GiorgosNtakos/Hummingbird-2-FPGA-Implementation-for-Lightweight-Authenticated-Encryption-in-IoT/Thesis_Implementation/README_GR.md

# Υλοποίηση Hummingbird-2 σε FPGA για Lightweight Authenticated Encryption στο IoT








---

## 📌 Περιγραφή

Το παρόν αποθετήριο περιέχει τον σχεδιασμό και την υλοποίηση σε υλικό ενός lightweight authenticated encryption συστήματος βασισμένου στον κρυπτογραφικό αλγόριθμο Hummingbird-2, με στόχο συσκευές Internet of Things (IoT) με περιορισμένους υπολογιστικούς πόρους.

Το σύστημα υλοποιήθηκε σε VHDL και βελτιστοποιήθηκε για αρχιτεκτονικές FPGA με έμφαση στην απόδοση, την αποδοτικότητα υλικού και την ασφάλεια. Υποστηρίζει λειτουργίες κρυπτογράφησης, αποκρυπτογράφησης, αυθεντικοποίησης και επαλήθευσης MAC για εφαρμογές RFID και ασύρματων δικτύων αισθητήρων.

---

## 🎓 Ακαδημαϊκό Πλαίσιο

Το έργο εκπονήθηκε ως **Διπλωματική Εργασία (Integrated Master)** στο:

**Τμήμα Μηχανικών Η/Υ & Πληροφορικής (CEID)**  
Πανεπιστήμιο Πατρών  

Συγγραφέας: Γεώργιος Ντάκος  
Επιβλέπων: Καθηγητής Νικόλαος Σκλάβος  
Περίοδος εκπόνησης: Δεκέμβριος 2022 — Οκτώβριος 2024  
Παρουσίαση: Οκτώβριος 2024  

---

## 🔐 Υπόβαθρο

Η ραγδαία ανάπτυξη του Internet of Things δημιουργεί αυστηρές απαιτήσεις για ασφαλή επικοινωνία σε συστήματα με περιορισμένους υπολογιστικούς πόρους. Η lightweight κρυπτογραφία παρέχει λύσεις χαμηλής κατανάλωσης, μικρού κόστους υλικού και υψηλής αποδοτικότητας.

Ο Hummingbird-2 αποτελεί έναν υβριδικό lightweight authenticated encryption αλγόριθμο σχεδιασμένο για τέτοια περιβάλλοντα, συνδυάζοντας χαρακτηριστικά block και stream ciphers και παρέχοντας εμπιστευτικότητα και ακεραιότητα δεδομένων.

---

## ⚙️ Χαρακτηριστικά Συστήματος

- Lightweight authenticated encryption (AEAD)  
- Πλήρης υλοποίηση σε VHDL  
- Υποστήριξη κρυπτογράφησης και αποκρυπτογράφησης  
- Αυθεντικοποίηση μηνυμάτων (παραγωγή και έλεγχος MAC)  
- Βελτιστοποίηση αρχιτεκτονικής ως προς απόδοση και κόστος υλικού  
- Κατάλληλο για εφαρμογές RFID και ασύρματων αισθητήρων  

---

## 🧠 Πλατφόρμα Υλικού

- FPGA στόχος: Xilinx Artix-7 (xc7a200tffg1156-3)  
- Γλώσσα υλοποίησης: VHDL  
- Προσομοίωση: ModelSim – Intel FPGA Starter Edition 10.5b  
- Σύνθεση & Υλοποίηση: Xilinx Vivado 2019.2 WebPACK Edition  

⚠️ Η υλοποίηση έχει επαληθευτεί σε μοντέλο FPGA. Μελλοντική εργασία περιλαμβάνει υλοποίηση σε πραγματική πλακέτα Basys3 Artix-7.

---

## 📂 Δομή Αποθετηρίου

/src → Πηγαίος κώδικας VHDL  
/sim → Αρχεία προσομοίωσης και testbenches  
/constraints → Αρχεία περιορισμών FPGA  
/docs → Κείμενο διπλωματικής και παρουσίαση  
/results → Αναφορές υλοποίησης και αποτελέσματα
/test_vectors → Διανύσματα Δοκιμής για επαλήθευση στα TBs   

---

## 📊 Περιοχές Εφαρμογής

- Ασφαλείς επικοινωνίες IoT  
- Συστήματα αυθεντικοποίησης RFID  
- Ασύρματα δίκτυα αισθητήρων  
- Ενσωματωμένα συστήματα ασφάλειας  
- Συσκευές με περιορισμένους πόρους  

---

## 🔮 Μελλοντική Εργασία

Προγραμματίζεται υλοποίηση και επαλήθευση σε πραγματική πλακέτα Basys3 Artix-7 για αξιολόγηση της απόδοσης σε πραγματικές συνθήκες λειτουργίας.

---

## ⚠️ Σημείωση

Η υλοποίηση παρέχεται αποκλειστικά για ακαδημαϊκούς και ερευνητικούς σκοπούς.

---

## 📖 Αναφορά (Citation)

Εάν χρησιμοποιήσετε την εργασία σε ερευνητικό ή ακαδημαϊκό πλαίσιο, παρακαλείστε να την αναφέρετε σύμφωνα με το BibTeX που παρέχεται στο κύριο README.

---

## 📜 Άδεια Χρήσης

Το έργο διατίθεται υπό την άδεια BSD 3-Clause.
