GiorgosNtakos/Hummingbird-2-FPGA-Implementation-for-Lightweight-Authenticated-Encryption-in-IoT/Thesis_Implementation/docs/thesis_presentation_final.pptx

## ΣχεδιασµΟς και ΥΛΟΠΟΙΗΣη Lightweight Authenticated ΣυστΗµατος ΚρυπτογρΑφησης, για το ΔιαδΙκτυο των ΠραγµΑτων

- Γεώργιος Ντάκος
- Επιβλέπων: Νικόλαος Σκλάβος
- Παρουσίαση Διπλωματικής Εργασίας
- Τμήμα Μηχανικών Ηλεκτρονικών Υπολογιστών και Πληροφορικής,
- Πανεπιστήμιο Πατρών
- Οκτώβριος, 2024

## Περίγραμμα Παρουσίασης

- Ανάγκη για Ασφαλή και Αποδοτικά Συστήματα στο Internet of Things (IoT)
- Υλοποίηση και Στόχοι της Εργασίας
- Ρόλος της Κρυπτογραφίας και Προκλήσεις Ασφάλειας στο IoT
- Βασικά Κρυπτογραφικά Δομικά Στοιχεία
- Οικογένεια Hummingbird (HB)
- Προτεινόμενος Σχεδιασμός και Βελτιστοποιήσεις
- Σύγκριση Αποτελεσμάτων
- Συμπεράσματα και Μελλοντικές Βελτιστοποιήσεις

## Ανάγκη για Ασφαλή και Αποδοτικά Συστήματα στο IoT

- Με τη ραγδαία ανάπτυξη του IoT απαιτούνται λύσεις με χαμηλή καθυστέρηση, υψηλή ταχύτητα και χαμηλή κατανάλωση.
- Στοχοποίηση IoT συσκευών λόγω ανεπαρκών μηχανισμών ασφαλείας και ενημερώσεων.
- Ανάγκη για αποδοτικά πρωτόκολλα ασφάλειας που προστατεύουν τα δεδομένα, εξασφαλίζοντας ταυτόχρονα υψηλή απόδοση.
- Η διείσδυση του IoT στην καθημερινή ζωή απαιτεί ασφαλείς επικοινωνίες σε τομείς όπως η υγεία και οι έξυπνες πόλεις.
- Η διασύνδεση και η μεταφορά ευαίσθητων δεδομένων αυξάνουν την πολυπλοκότητα και τον κίνδυνο των επιθέσεων.

## Υλοποίηση και Στόχοι της Εργασίας

- Υλοποίηση του HB-2:
  - Βελτιστοποιημένη έκδοση HB-2 σε FPGA, με έμφαση την αποδοτικότητα και ασφάλεια.
- Αύξηση Απόδοσης:
  - Βελτιώσεις στη συχνότητα λειτουργίας και μείωση της επιφάνειας υλικού.
- Βελτιστοποίηση Αρχιτεκτονικής:
  - Τεχνικές για μείωση κόστους και βελτίωση απόδοσης σε συσκευές με περιορισμένους πόρους.
- Προσαρμογή σε Εφαρμογές με Περιορισμένους Πόρους:
  - Σχεδιασμός για RFID και ασύρματους αισθητήρες, με στόχο την εξοικονόμηση πόρων και ασφάλεια.

## Ρόλος της Κρυπτογραφίας στο IoT & Προκλήσεις Ασφάλειας

- Ασφάλεια δικτύου.
- Αυθεντικοποίηση.
- Αξιοπιστία Επικοινωνιών.
- Περιορισμένοι Πόροι.
- Έλλειψη Προτύπων.
- Εξάρτηση από Παρόχους.
- Ελλιπής Εκπαίδευση.

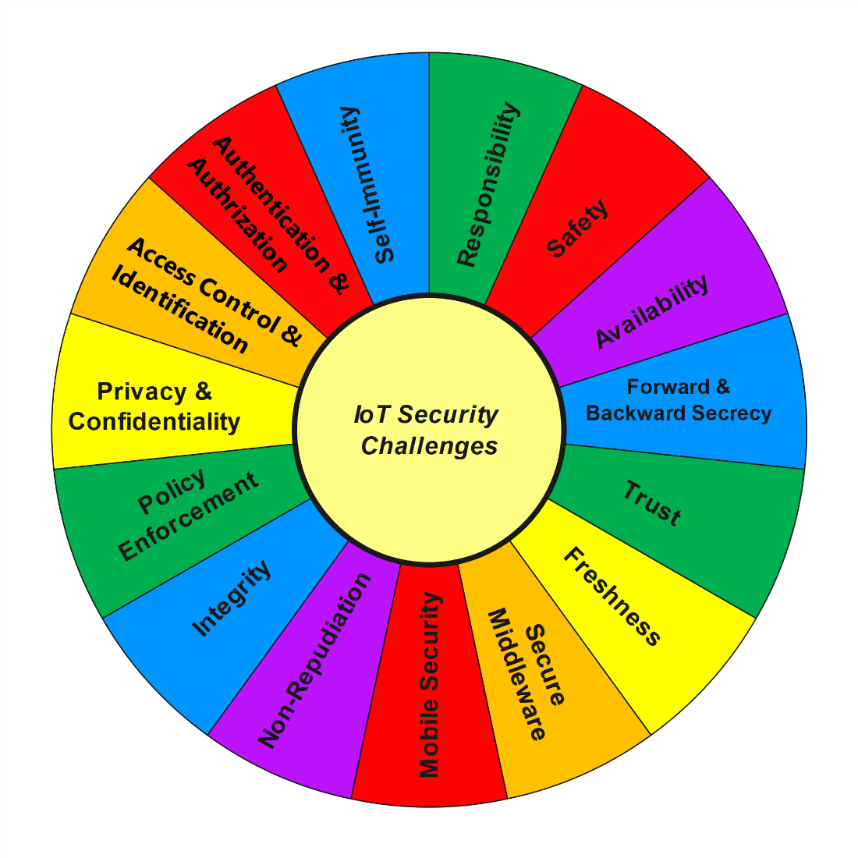
[picture p7: figure]
Εικόνα που περιέχει κείμενο, compact disc, κύκλος, συσκευή αποθήκευσης δεδομένων Περιγραφή που δημιουργήθηκε αυτόματα

## Είδη Κρυπτογραφικών Αλγορίθμων

- Δύο τύποι κρυπτογραφικών αλγορίθμων:
  - Συμμετρικοί.
  - Ασύμμετροι.
- Η επιλογή του κατάλληλου αλγόριθμου εξαρτάται από τις απαιτήσεις ασφάλειας και τους περιορισμούς των IoT συσκευών.
- Lightweight κρυπτογραφία: Συνήθης επιλογή σε IoT με περιορισμένους πόρους.
- Τύποι συμμετρικής κρυπτογράφησης:
  - Αλγόριθμοι Τμήματος (Block Ciphers).
  - Αλγόριθμοι Ροής (Stream Ciphers).

## Αλγόριθμοι Τμήματος και Δομή SPN

- Αλγόριθμοι Κρυπτογράφησης Τμήματος:
  - Επεξεργάζονται δεδομένα σε μπλοκ (64 ή 128 bits), εξασφαλίζοντας υψηλή ασφάλεια.
  - Δημοφιλείς Αρχιτεκτονικές: SPN, Feistel, ARX.
  - Πλεονεκτήματα: Υψηλή ασφάλεια, κατάλληλοι για μεγάλα δεδομένα.
  - Μειονεκτήματα: Αυξημένη πολυπλοκότητα και χαμηλότερη ταχύτητα σε σχέση με τους αλγόριθμους ροής.
- SPN Δομή:
  - Λειτουργία S-boxes: Δυσκολεύουν την ανάλυση δεδομένων.
  - Λειτουργία P-boxes: Κατανέμουν την πληροφορία ομοιόμορφα στο μπλοκ.
  - Προσθήκη Κλειδιού: Κάθε γύρος προσθέτει το κλειδί για επιπλέον ασφάλεια.

## Αλγόριθμοι Ροής

- Αλγόριθμοι Ροής:
  - Κρυπτογραφούν διαδοχικά, χρησιμοποιώντας μια κλειδοροή (keystream).
  - Πλεονεκτήματα: Υψηλή ταχύτητα, χαμηλή πολυπλοκότητα, ιδανικοί για συστήματα με περιορισμένους πόρους.
  - Μειονεκτήματα: Ευπάθεια σε επαναχρησιμοποίηση της κλειδοροής.
- Δομές :
  - LFSR
  - NFSR

## Η Οικογένεια Hummingbird

- Σχεδιασμένοι για συσκευές με περιορισμένους πόρους.
- Υβριδική δομή.
- Ιδανικοί για περιβάλλοντα με απαιτήσεις ταχείας απόκρισης και χαμηλή κατανάλωση.
- Ο HB-2 βελτιώνει την απόδοση και ασφάλεια του αρχικού HB-1.

## Γενική Αρχιτεκτονική HB-2

- Ο ΗΒ-2:
  - Αναπτύχθηκε για να βελτιώσει τον HB-1 και είναι ιδανικός για συσκευές με περιορισμένους πόρους (RFID).
  - Υλοποιείται με πράξεις των 16 bit: XOR ( ⊕ ), Modulo 2^16 (⊞) και f(x) .
- Μυστικό Κλειδί & Εσωτερική Κατάσταση:
  - Μυστικό κλειδί των 128 bit, χωρισμένο σε 8 υποκλειδιά.
  - Εσωτερική κατάσταση των 128 bit, αρχικοποιείται με διανύσματα των 64 bit.
- Αύξηση Ασφάλειας:
  - Μεγαλύτερη εσωτερική κατάσταση για περισσότερη ασφάλεια.
  - Κατάργηση του LFSR για απλοποίηση και καλύτερη απόδοση.

## S-boxes του HB-2

- Κεντρικός ρόλος στην υλοποίηση της σύγχυσης.
- Προστασία από επιθέσεις γραμμικής και διαφορικής κρυπτανάλυσης.

Τα S-boxes που χρησιμοποιούνται στην κρυπτογράφηση στον Hummingbird-2.

Τα S-boxes που χρησιμοποιούνται στην αποκρυπτογράφηση στον Hummingbird-2.

## Slide 12

- Σκοπός:
  - Ενισχύει τη διάχυση και τη σύγχυση στα δεδομένα, παρέχοντας μη γραμμικότητα και δυσκολία πρόβλεψης της εξόδου.
- Υπολογισμός:
  - S(x)= S_1 (x_0 )| S_2 (x_1 )|S_3 (x_2 )|S_4 (x_3 )
  - L(x)= x⊕(x≪6)⊕(x≪10)
  - f(x)= L(S(x))

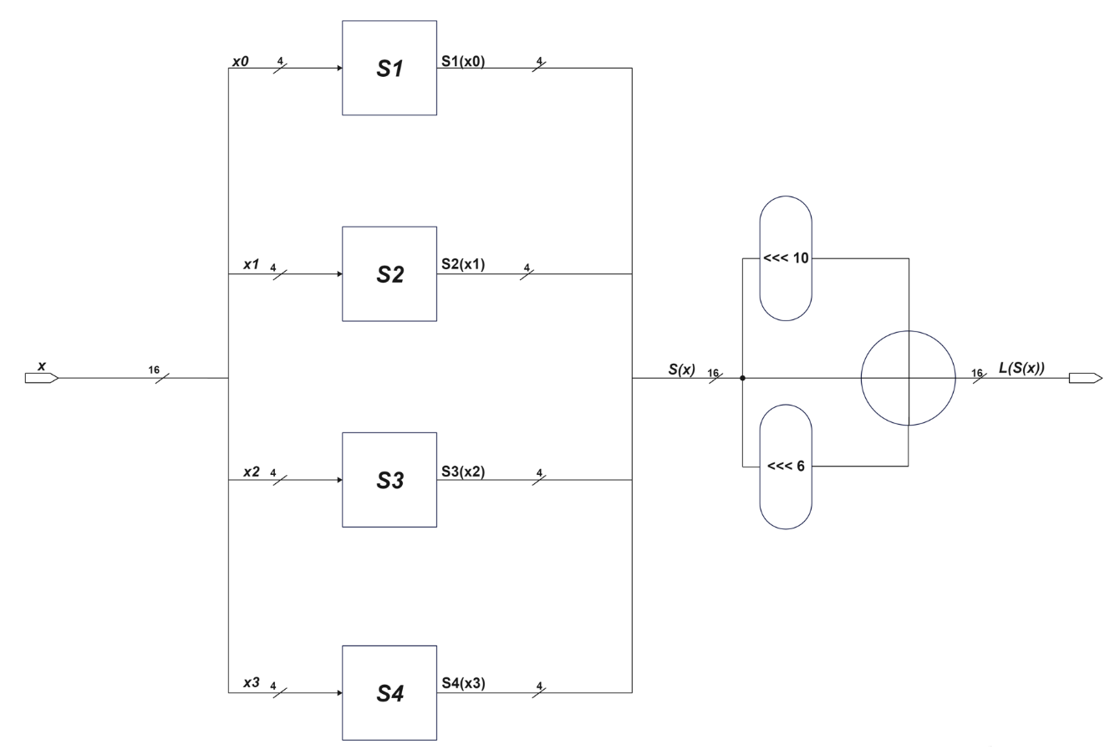
[picture p8: figure]

## Slide 13

- Παρέχει την κύρια κρυπτογραφική λειτουργία του Hummingbird-2.
- Υλοποιεί την συνάρτηση f(x) τέσσερις φορές με προσθήκη υποκλειδιών κάθε φορά.
- Βασίζεται στην SPN Δομή.
- Υπολογισμός:
  - WD16(x,a,b,c,d)=f(f(f(f(x⊕a)⊕b)⊕c)⊕d)

## Slide 14

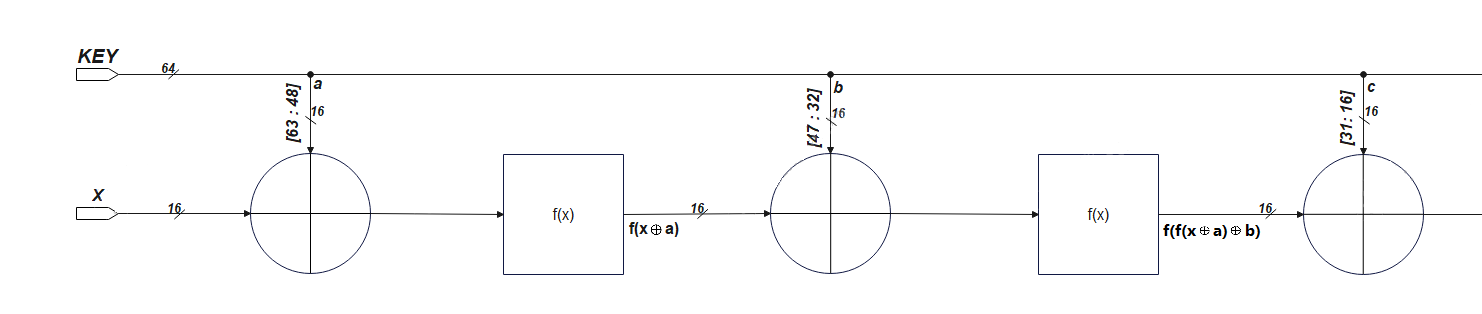
[picture p9: figure]
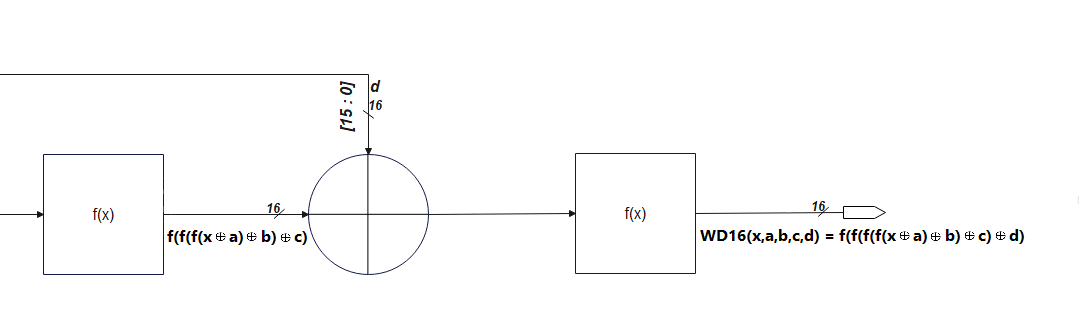
[picture p10: figure]

## Αρχιτεκτονική και Διαδικασία Αρχικοποίησης

- Σκοπός:
  - Καθορίζει την αρχική εσωτερική κατάσταση με τη χρήση του διανύσματος IV .
- Διαδικασία:
  - Χρησιμοποιούνται καταχωρητές , οι οποίοι ενημερώνονται μετά από τέσσερις γύρους.
  - Η συνάρτηση WD16 εφαρμόζεται σε κάθε γύρο με τα αντίστοιχα υποκλειδιά.

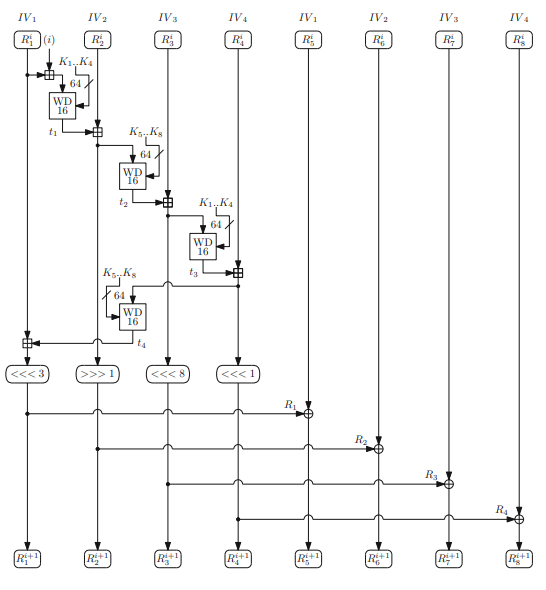
[picture p11: figure]

## Αρχιτεκτονική και Διαδικασία Κρυπτογράφησης των 16 bit Μπλοκ

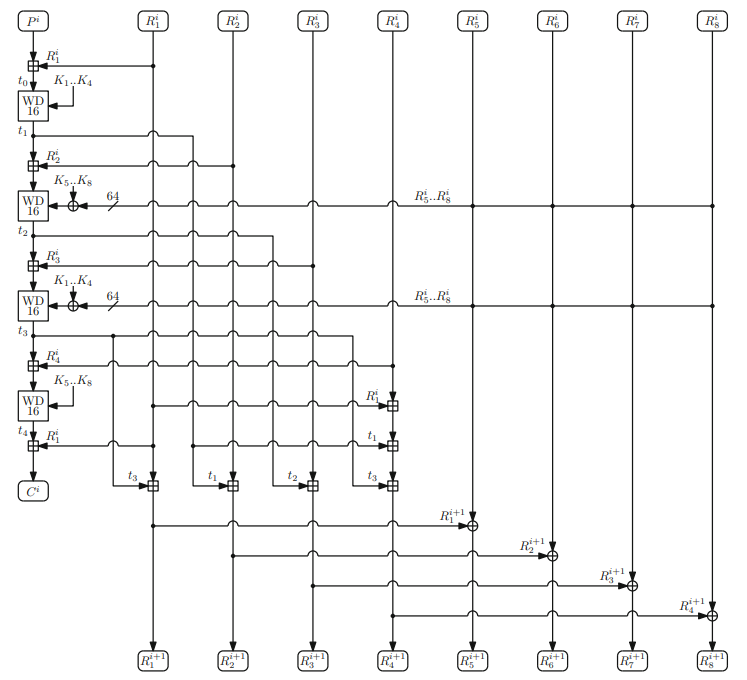
[picture p12: figure]

- Κάθε μπλοκ των 16 bit P_i κρυπτογραφείται σε τέσσερις γύρους με τη συνάρτηση WD16 .
- Υπολογισμός των γύρων:
  - t_1 =WD16(R_1^((i)) ⊞P_i , K_1 ,K_2 ,K_3 ,K_4 )
  - t_2 =WD16(R_2^((i)) ⊞t_1 , K_5 ⊕R_5^((i)) ,K_6 ⊕R_6^((i)) ,K_7 ⊕R_7^((i)) ,K_8 ⊕R_8^((i)) )
  - t_3 =WD16(R_3^((i)) ⊞t_2 , K_1 ⊕R_5^((i)) ,K_2 ⊕R_6^((i)) ,K_3 ⊕R_7^((i)) ,K_4 ⊕R_8^((i)) )
  - C_i =WD16(R_4^((i)) ⊞t_3 , K_5 ,K_6 ,K_7 ,K_8 )⊞R_1^((i))

## Stream Cipher Κωδικοποίηση Πεδίων Μικρού Μήκους

- Σχεδιάστηκε για μηνύματα μικρότερα από 16 bits ( 1≤n≤15 ) χωρίς αύξηση του μεγέθους.
- Διαδικασία:
  - Κρυπτογράφηση με τη μηδενική λέξη E(0) των 16 bit.
  - Το τελικό μήνυμα υπολογίζεται ως x⊕E(0) .
  - Παρέχεται επιπλέον ασφάλεια με ενημέρωση της εσωτερικής κατάστασης.

## Μονάδα Υπολογισμού MAC

- Παρέχει ακεραιότητα και αυθεντικότητα στα μηνύματα του HB-2.
- Διαδικασία Υπολογισμού:
  - Τρεις κλήσεις της E για την ενημέρωση της εσωτερικής κατάστασης:
    - E(IV_1 ⊞R_1 ⊞R_3 ⊞n)
    - E(IV_2 ⊞R_1 ⊞R_3 )
    - E(IV_3 ⊞R_1 ⊞R_3 )
- Παραγωγή MAC:
  - T_1 =E(IV_4 ⊞R_1 ⊞R_3 )
  - T_i =E(R_1 ⊞R_3 ), με i=2,3,…,n

## Slide 19

- Η αντίστροφη της f(x) υπολογίζεται ως:
  - f^(−1) (x)=L^(−1) (S^(−1) (y))
  - L^(−1) (x)=y⊕(x_(old) ≫6 )⊕ (x_(old) ≫10 )
  - word_(output) =S_1^(−1) (x_(new_0) )|S_2^(−1) (x_(new_1) )|S_3^(−1) (x_(new_2) )|S_4^(−1) (x_(new_3) )
- Αντιστροφή της WD16:
  - WD16^(−1) (x,a,b,c,d)=f^(−1) (f^(−1) (f^(−1) (f^(−1) (x⊕a)⊕b)⊕c)⊕d)

## Slide 20

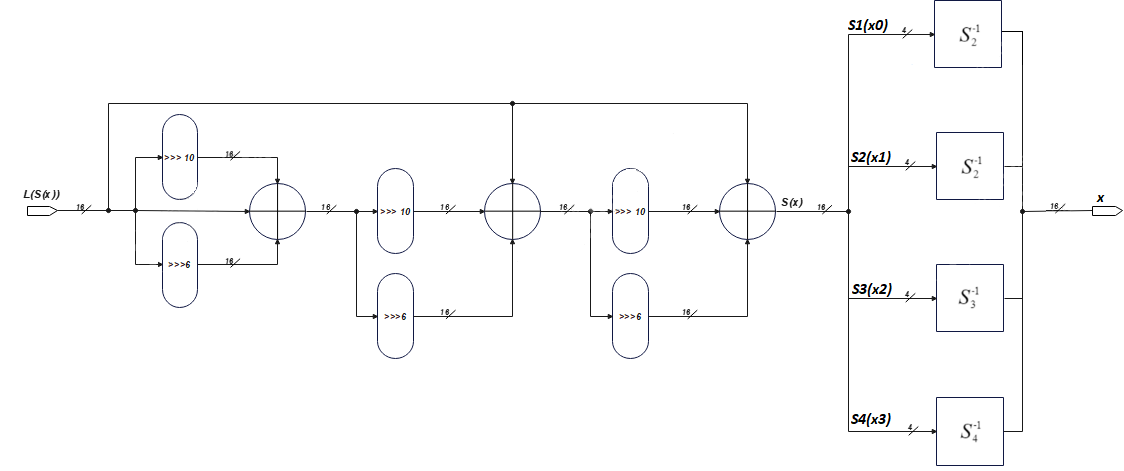
[picture p13: figure]
Εικόνα που περιέχει διάγραμμα, γραμμή, τεχνικό σχέδιο, Σχέδιο Περιγραφή που δημιουργήθηκε αυτόματα

## Slide 21

/

64

WD(x,a,b,c,d)

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
WD16⁻¹(x,a,b,c,d)

/

## Αρχιτεκτονική και Διαδικασία Αποκρυπτογράφησης

- Αποκρυπτογράφηση:
  1. u_3 =WD16^(−1) (C_i ⊟R_1^((i)) , K_8 ,K_7 ,K_6 ,K_5 )
  2. u_2 =WD16^(−1) (u_3 ⊟R_4^((i)) , K_4 ⊕R_8^((i)) ,K_3 ⊕R_7^((i)) ,K_2 ⊕R_6^((i)) ,K_1 ⊕R_5^((i)) )
  3. u_1 =WD16^(−1) (u_2 ⊟R_3^((i)) , K_8 ⊕R_8^((i)) ,K_7 ⊕R_7^((i)) ,K_6 ⊕R_6^((i)) ,K_5 ⊕R_5^((i)) )
  4. P_i =WD16^(−1) (u_i ⊟R_2^((i)) , K_4 ,K_3 ,K_2 ,K_1 )
- Η εσωτερική κατάσταση ενημερώνεται:
  - t_3 =u_3 ⊟R_4^((i))
  - t_2 =u_2 ⊟R_3^((i))
  - t_1 =u_1 ⊟R_2^((i))

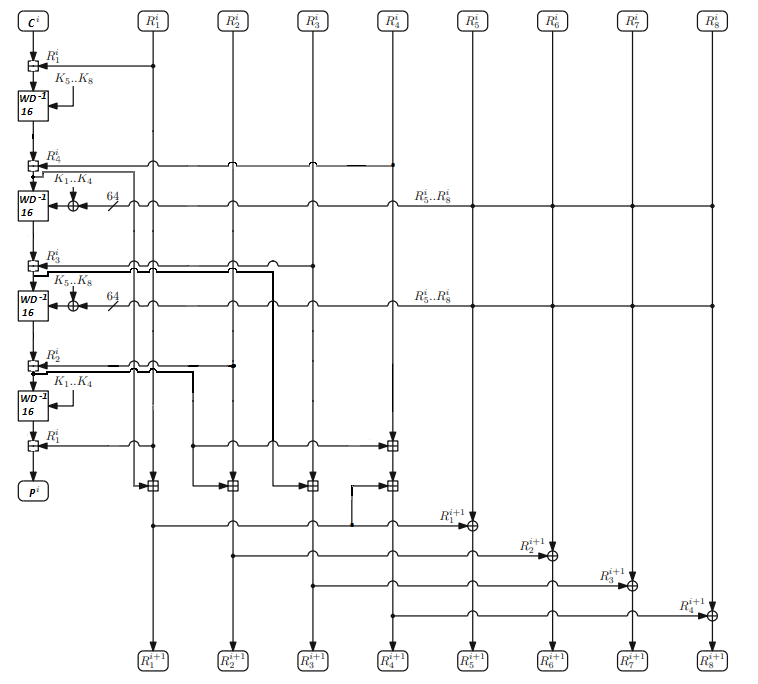
[picture p14: figure]

## Προτεινόμενος Σχεδιασμός HB-2

Σχεδιάστηκε επεξεργαστής HB-2 για 128 bit μπλοκ, με βασικές λειτουργίες:
  - Αρχικοποίηση (Initialization).
  - Κρυπτογράφηση (Encryption).
  - Λειτουργία stream cipher με ενσωματωμένη ακεραιότητα (Stream cipher mode with integrated integrity).
  - Αυθεντικοποίηση (Authentication).
  - Έλεγχος MAC (MAC verification unit).
Για την ομαλή λειτουργία και απόδοση:
  - Μηχανή πεπερασμένων καταστάσεων (FSM).
  - Μονάδα διαχείρισης σημάτων ελέγχου.

## Μηχανή πεπερασμένων καταστάσεων

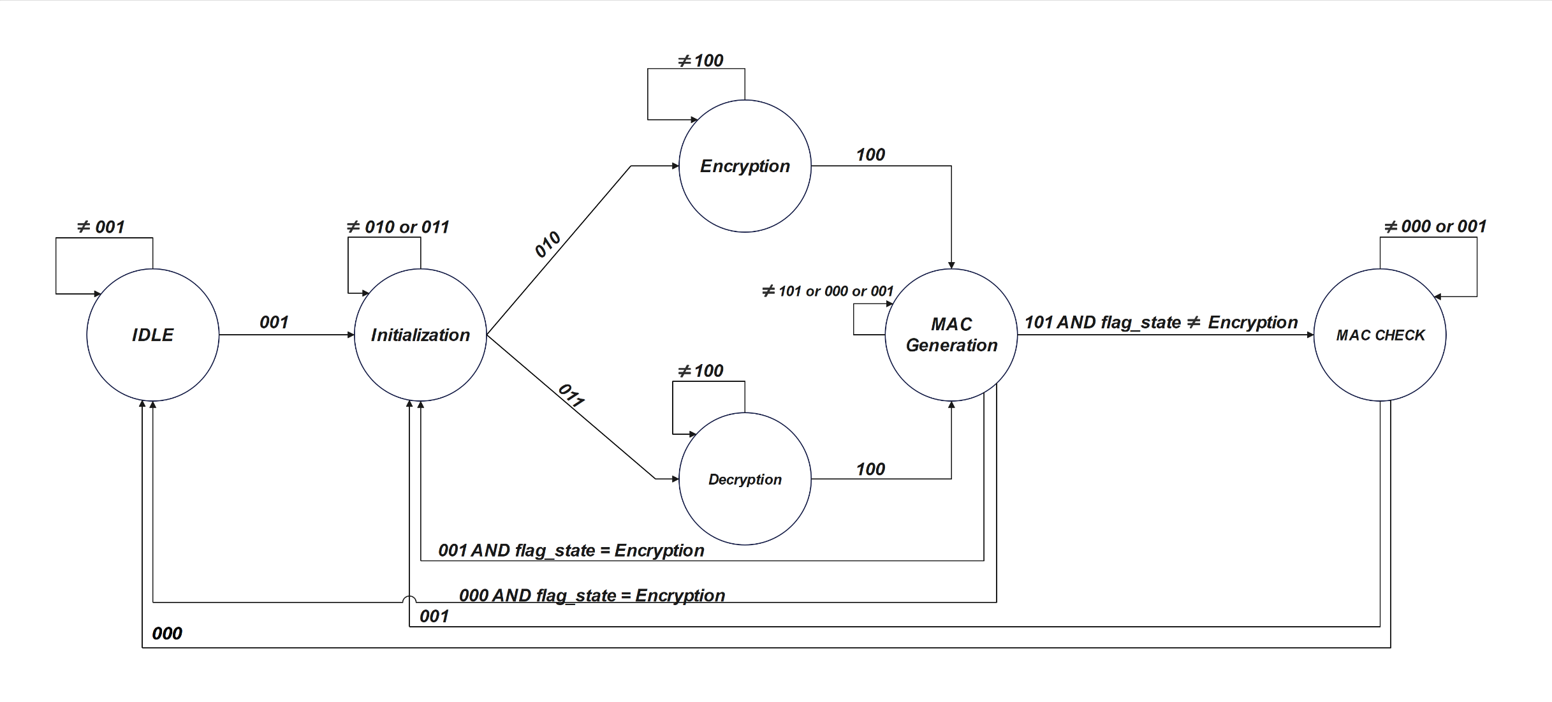
[picture p15: figure]
Εικόνα που περιέχει κείμενο, διάγραμμα, σκίτσο/σχέδιο, γραμμή Περιγραφή που δημιουργήθηκε αυτόματα

## Βελτιστοποίηση στο Κόστος Υλικού

- Αρχικά απαιτούνταν 21 μπλοκ κρυπτογράφησης.
- Προτεινόμενη αρχιτεκτονική:
  - 1 μπλοκ για ανανέωση εσωτερικής κατάστασης (αυθεντικοποίηση).
  - 2 μπλοκ για περαιτέρω ανανέωση (αυθεντικοποίηση και stream cipher).
  - 8 μπλοκ για κρυπτογράφηση και δημιουργία των tags αυθεντικοποίησης.
- Μείωση επιφάνειας κρυπτογραφικών μπλοκ κατά 48% .

## Βελτιστοποίηση στη Συχνότητα Ρολογιού

- Στόχος :
  - Αύξηση της συχνότητας για βελτίωση της απόδοσης.
  - Διατήρηση όσο το δυνατόν χαμηλότερη επιφάνεια και κατανάλωση ενέργειας.
- Κύριες Τεχνικές Βελτιστοποίησης:
  - Pipe-lining για μείωση καθυστερήσεων και αύξηση της συχνότητας:
    - Εφαρμογή σε μονάδες WD^(−1) 16 και f^(−1) (x) .
    - Αποθήκευση S-boxes σε καταχωρητές για ταχύτερη επεξεργασία.
    - Διαχωρισμός πράξεων σε στάδια για αύξηση απόδοσης.
- Από 34,5 MHz →243,902 MHz , αύξηση κατά 607% .

## Slide 27

- Προστέθηκε στάδιο pipe-line για αποθήκευση των εξόδων των S-boxes σε καταχωρητές τεσσάρων bit.
- Για τη μονάδα f^(−1) (x) προστέθηκαν 4 στάδια pipe-line.

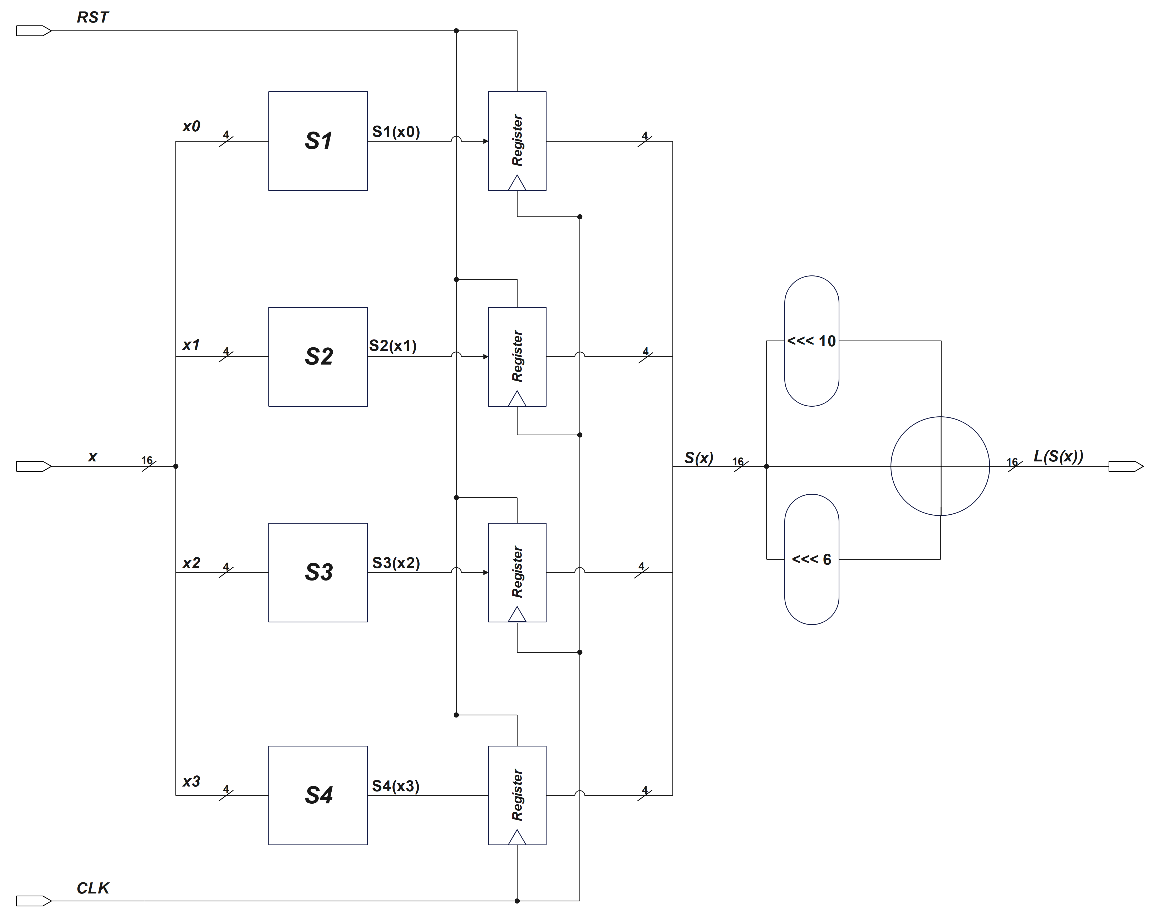
[picture p16: figure]

## Slide 28

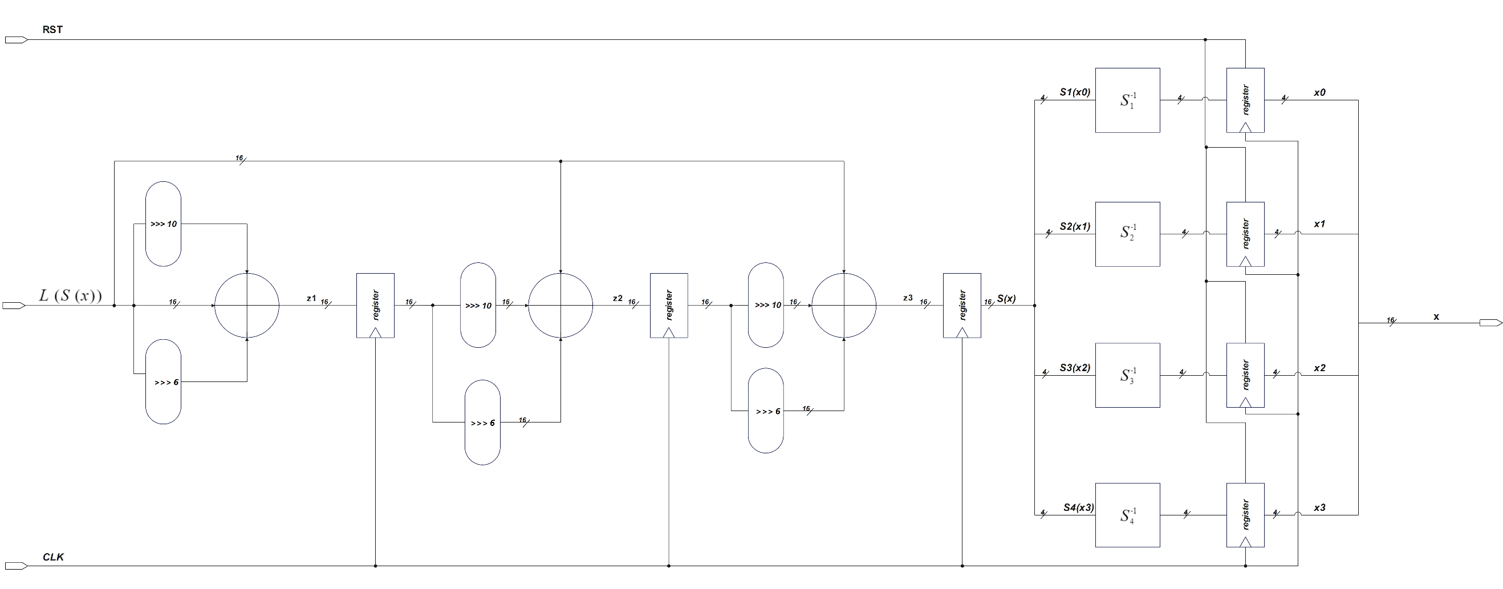
[picture p17: figure]
Εικόνα που περιέχει διάγραμμα, γραμμή, παράλληλα, τεχνικό σχέδιο Περιγραφή που δημιουργήθηκε αυτόματα

## Slide 29

Λόγω του ότι είναι πιο πολύπλοκη από την WD16 εφαρμόστηκε τεχνική pipe-line 4 σταδίων.

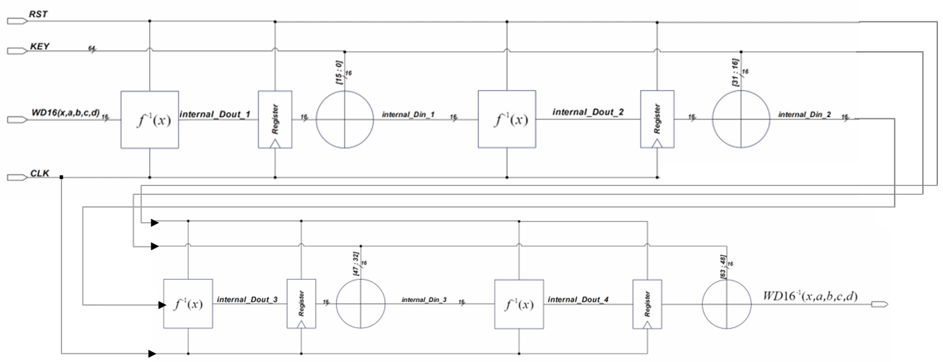
[picture p18: figure]
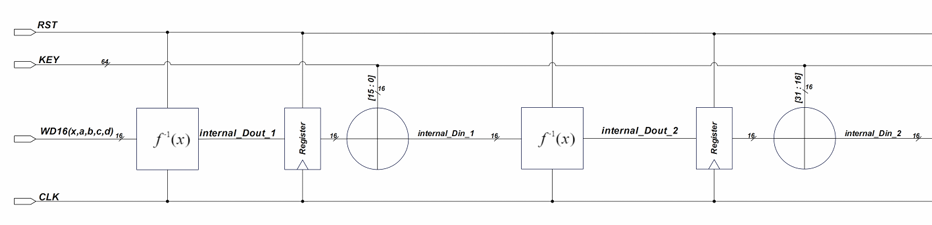
[picture p19: figure]

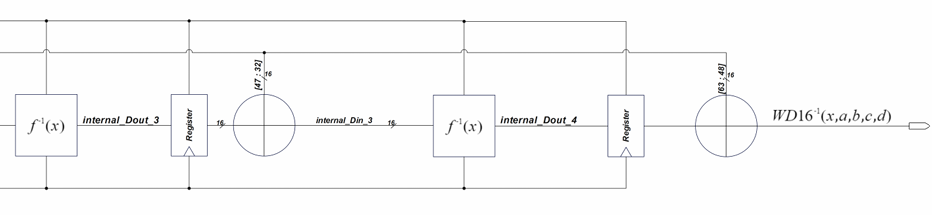
[picture p20: figure]

## Slide 30

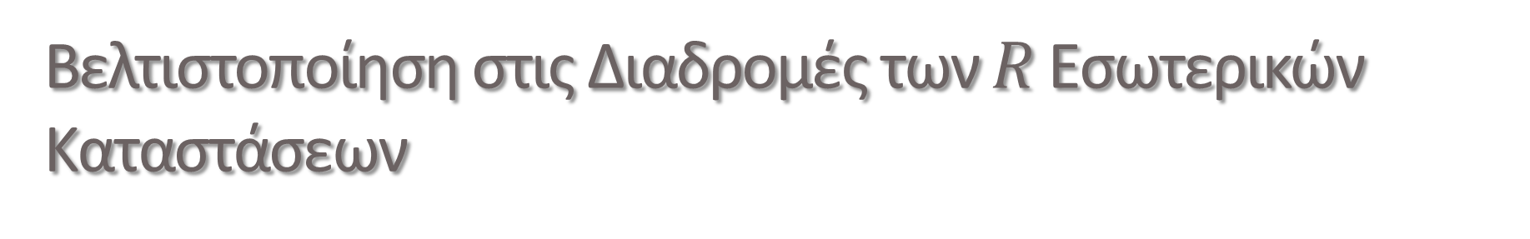
[picture p21: figure]

- Τεσσάρων σταδίων pipe-line:
  1. Πράξεις προσθέσεων.
  2. Υπολογισμός πράξεων modulo 2^16 .
  3. Κυκλικές μετατοπίσεις.
  4. Πράξεις XOR.
- Δύο σταδίων pipe-line:
  1. Υπολογισμός προσθέσεων.
  2. Υπολογισμός πράξεων modulo 2^16 .

## Αρχιτεκτονική Pipe-lining Τεσσάρων Σταδίων

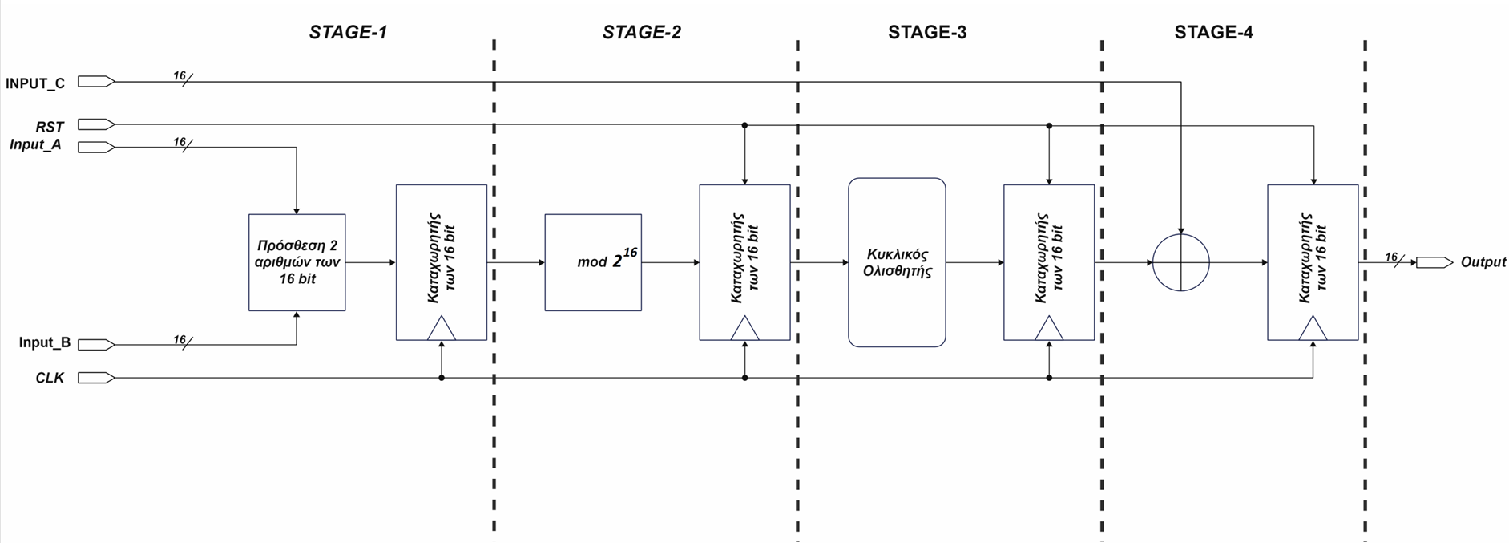
[picture p22: figure]

## Αρχιτεκτονική Pipe-lining Δύο Σταδίων

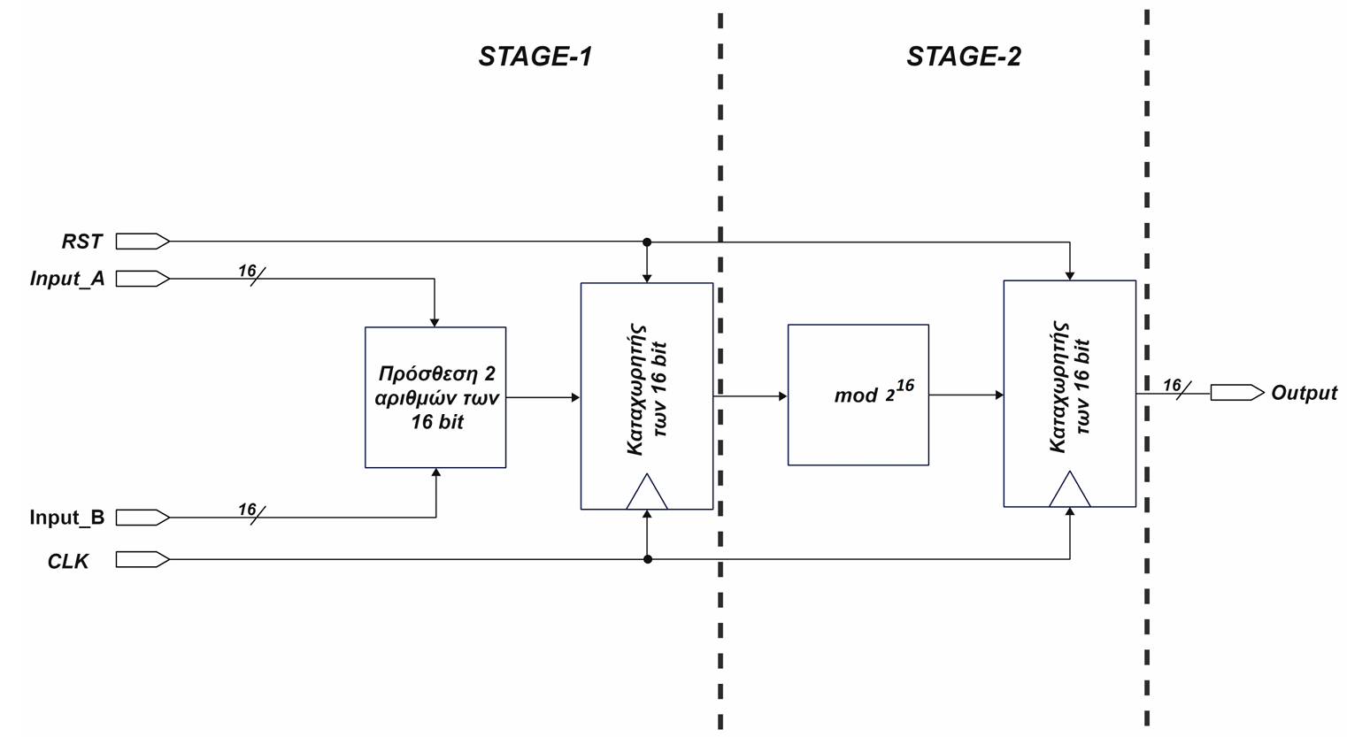
[picture p23: figure]

## Σύγκριση HB-2 με Άλλους Κρυπτογραφικούς Αλγόριθμους(1)

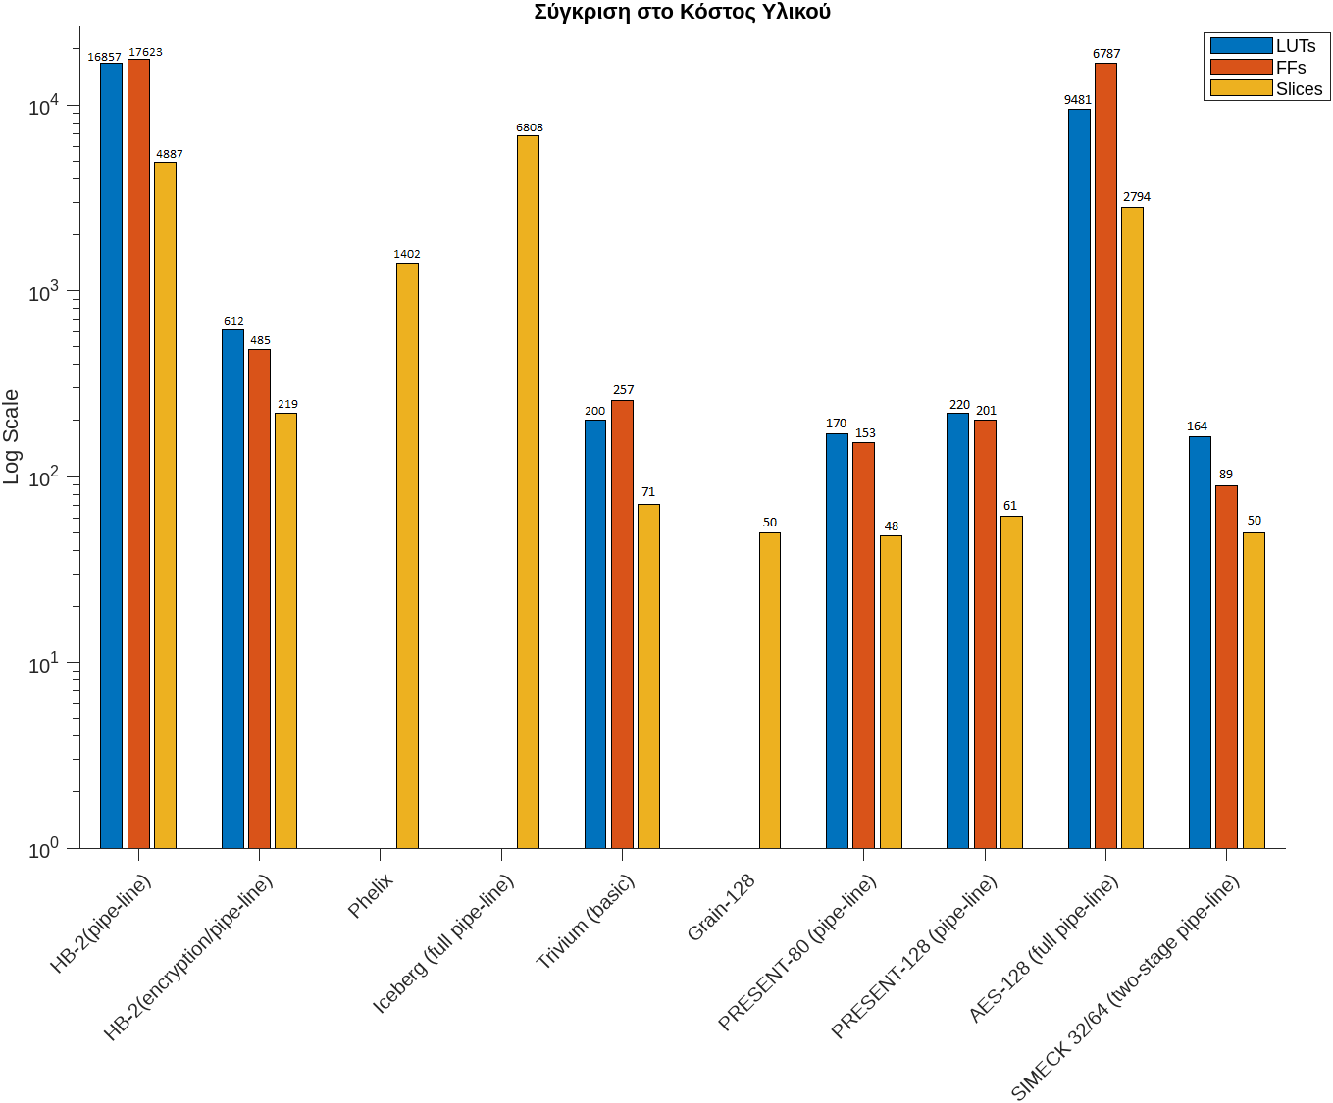
[picture p24: figure]
Εικόνα που περιέχει κείμενο, γραμμή, παράλληλα, διάγραμμα Περιγραφή που δημιουργήθηκε αυτόματα
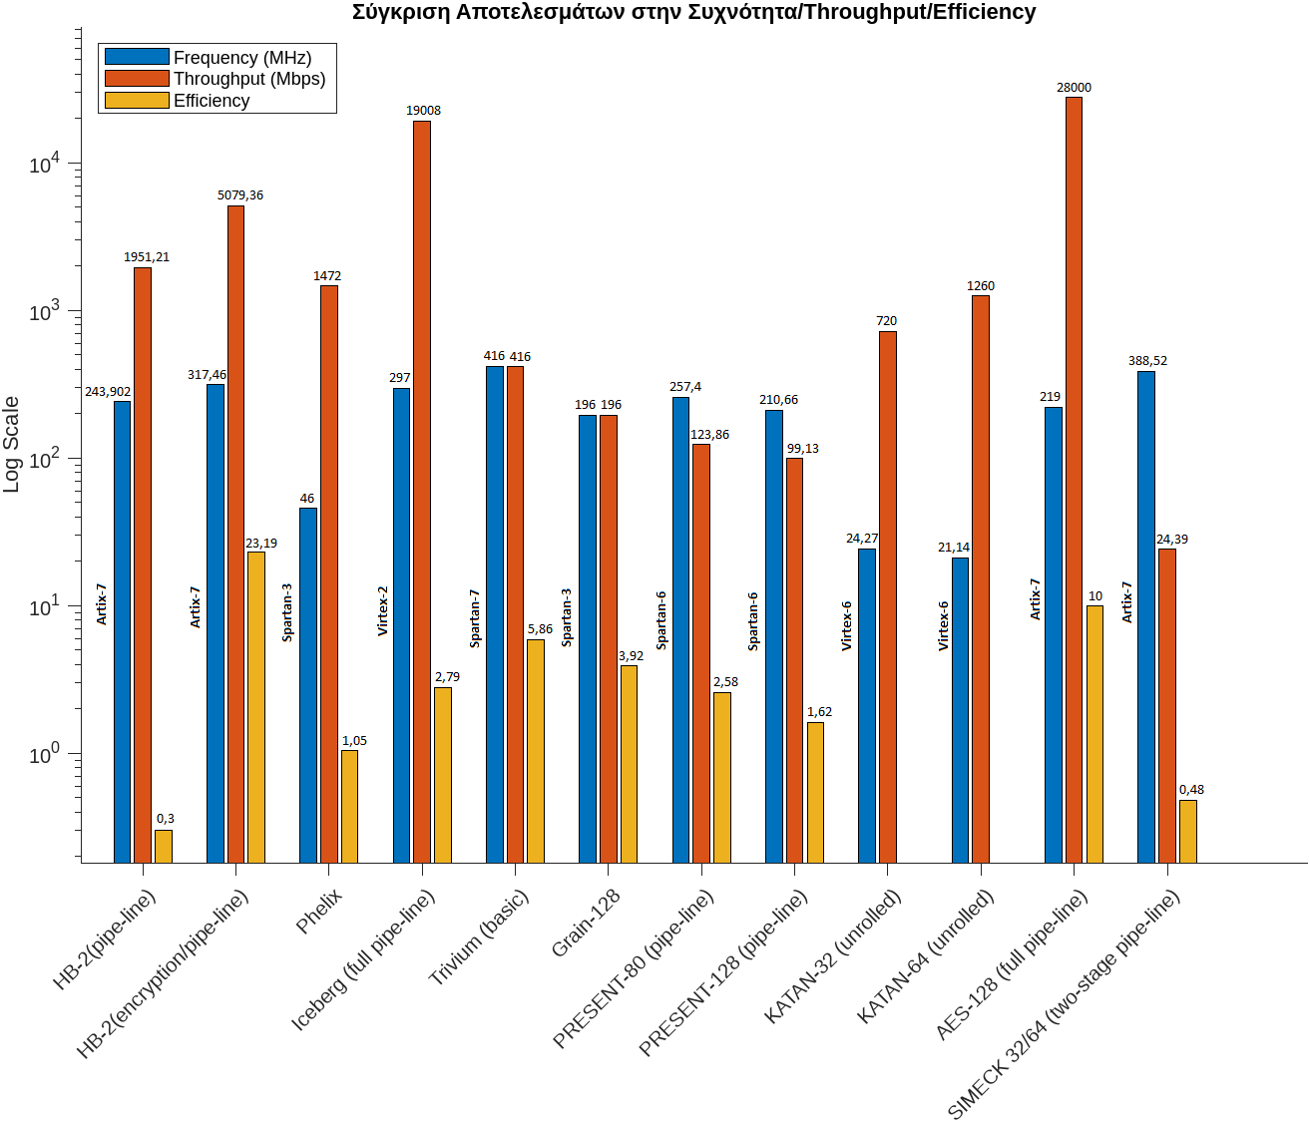
[picture p25: figure]

## Σύγκριση HB-2 με Άλλους Κρυπτογραφικούς Αλγόριθμους (2)

- O HB-2 με pipe-line αρχιτεκτονική αξιοποιεί τους πόρους αποδοτικά, υπερβαίνοντας άλλους αλγόριθμους.
- Εξασφαλίζει ικανοποιητικό throughput στην κρυπτογράφηση, ξεπερνώντας αρκετούς συγκρίσιμους αλγόριθμους.
- Παρά την πολυπλοκότητα και την ανάγκη για περισσότερους πόρους, διατηρεί υψηλή απόδοση σε εφαρμογές περιορισμένων πόρων.
- Ο HB-2 είναι κατάλληλος για συστήματα IoT και RFID, προσφέροντας ικανοποιητικό throughput.

## Σύγκριση HB-2 με Άλλες Υλοποιήσεις της Οικογένειας ΗΒ

- H pipe-line αρχιτεκτονική του HB-2 προσφέρει υψηλότερη συχνότητα και αυξημένη απόδοση κρυπτογράφησης σε σύγκριση με τον HB-1.
- Ο HB-2 βελτιώνει τις αδυναμίες ασφαλείας του HB-1, διατηρώντας ισορροπία μεταξύ ασφάλειας και απόδοσης, ιδανική για περιορισμένους πόρους.
- Η αυξημένη απαίτηση σε πόρους του HB-2 αντισταθμίζεται από την υψηλότερη απόδοση και την αποτελεσματική κρυπτογραφία.

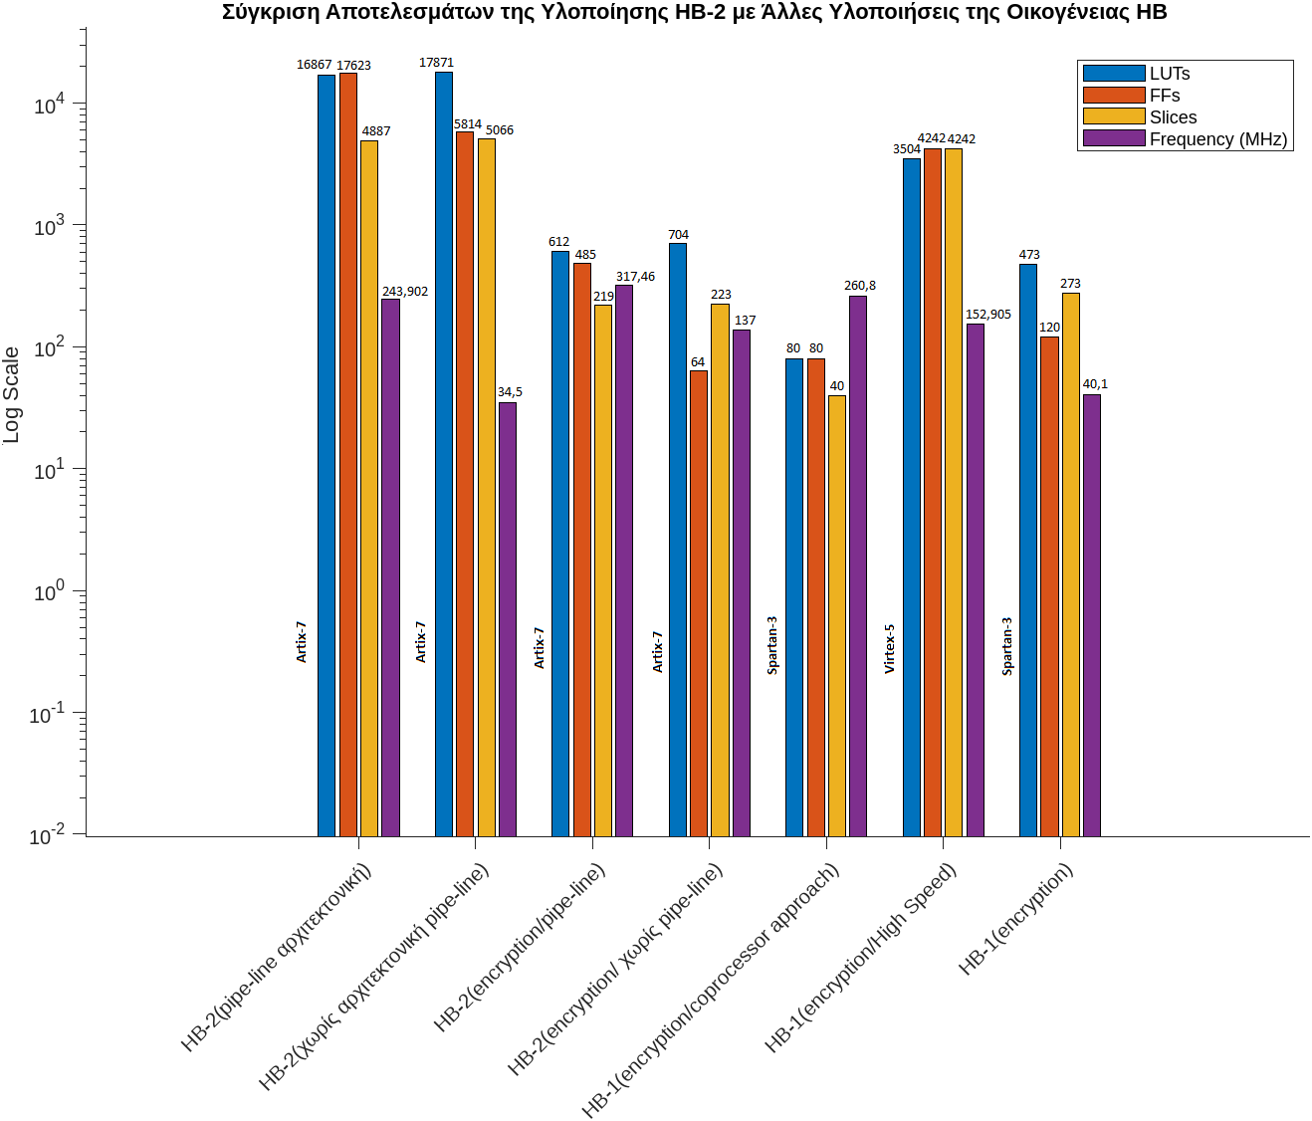
[picture p26: figure]

## Συμπεράσματα

- Μείωση 48% της επιφάνειας των μπλοκ κρυπτογράφησης.
- Αύξηση 607% στη συχνότητα ρολογιού και 132% στην απόδοση των 16 bit μπλοκ.
- Ικανοποιητικό throughput και υψηλό efficiency στη μονάδα κρυπτογράφησης.

## Μελλοντικές Κατευθύνσεις

- Χρήση μιας αρχιτεκτονικής επαναληπτικών γύρων (round-based) με μία συνάρτηση f(x) στην μονάδα WD16 για μείωση της επιφάνειας και της ενεργειακής κατανάλωσης.
- Αντικατάσταση της μονάδας WD16(x,k_1 ,k_2 ,k_3 ,k_4 ) με μια νέα συνάρτηση “S-boxeless” χ_ν (x,k_1 ,k_2 ,k_3 ,k_4 ) για την εξάλειψη των επιθέσεων κρυπτανάλυσης σχετικού κλειδιού (related-key cryptanalysis) και την μείωση σε απαιτήσεις υλικού.

## Αποτελέσματα Ερευνητικής Δραστηριότητας

- Τα αποτελέσματα αυτής της έρευνας καθώς και οι υλοποιήσεις των προτεινόμενων βελτιστοποιήσεων θα υποβληθούν προς δημοσίευση:
- G. Ntakos, N. Sklavos, “Design and Implementation of Related Key Attack-Preventing Lightweight Authenticated Security Scheme, for the IoT”, The 26th International Symposium on Quality Electronic Design (ISQED’25), 23-25 April, San Francisco California, USA, (Submitted: October 2024).

## Σας ευχαριστώ πολύ για το χρόνο και το ενδιαφέρον σας !

Ερωτήσεις;
