GiorgosNtakos/Hummingbird-2-FPGA-Implementation-for-Lightweight-Authenticated-Encryption-in-IoT/Basys3_UART_GUI_Architecture/images/about_tab.png

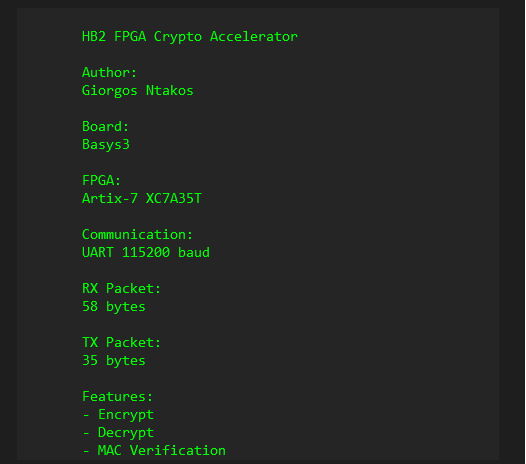
Basys3_UART_GUI_Architecture/images/about_tab.png
