GiorgosNtakos/Hummingbird-2-FPGA-Implementation-for-Lightweight-Authenticated-Encryption-in-IoT/Thesis_Implementation/results/performance_metrics.csv

Algorithm | Frequency_MHz | Throughput_Mbps | Efficiency
HB-2 (pipe-line) | 243.902 | 1951.21 | 0.3
HB-2 (encryption) / pipe-line | 317.46 | 5079.36 | 23.19
