GiorgosNtakos/Hummingbird-2-FPGA-Implementation-for-Lightweight-Authenticated-Encryption-in-IoT/Basys3_UART_GUI_Architecture/constraints/uart_tx_constraints.xdc

set_property -dict { PACKAGE_PIN W5 IOSTANDARD LVCMOS33 } [get_ports clk]
create_clock -add -name sys_clk_pin -period 10.00 -waveform {0 5} [get_ports clk]


## Reset switch - SW0
set_property -dict { PACKAGE_PIN V17 IOSTANDARD LVCMOS33 } [get_ports rst]

## UART RX-TX PINS
set_property -dict { PACKAGE_PIN A18   IOSTANDARD LVCMOS33 } [get_ports uart_tx_pin]
set_property -dict { PACKAGE_PIN B18   IOSTANDARD LVCMOS33 } [get_ports uart_rx_pin]

## LEDs
set_property -dict { PACKAGE_PIN U16 IOSTANDARD LVCMOS33 } [get_ports {led[0]}]
set_property -dict { PACKAGE_PIN E19 IOSTANDARD LVCMOS33 } [get_ports {led[1]}]
set_property -dict { PACKAGE_PIN U19 IOSTANDARD LVCMOS33 } [get_ports {led[2]}]
set_property -dict { PACKAGE_PIN V19 IOSTANDARD LVCMOS33 } [get_ports {led[3]}]
set_property -dict { PACKAGE_PIN W18 IOSTANDARD LVCMOS33 } [get_ports {led[4]}]
set_property -dict { PACKAGE_PIN U15 IOSTANDARD LVCMOS33 } [get_ports {led[5]}]
set_property -dict { PACKAGE_PIN U14 IOSTANDARD LVCMOS33 } [get_ports {led[6]}]
set_property -dict { PACKAGE_PIN V14 IOSTANDARD LVCMOS33 } [get_ports {led[7]}]
set_property -dict { PACKAGE_PIN V13 IOSTANDARD LVCMOS33 } [get_ports {led[8]}]
set_property -dict { PACKAGE_PIN V3  IOSTANDARD LVCMOS33 } [get_ports {led[9]}]
set_property -dict { PACKAGE_PIN W3  IOSTANDARD LVCMOS33 } [get_ports {led[10]}]
set_property -dict { PACKAGE_PIN U3  IOSTANDARD LVCMOS33 } [get_ports {led[11]}]
set_property -dict { PACKAGE_PIN P3  IOSTANDARD LVCMOS33 } [get_ports {led[12]}]
set_property -dict { PACKAGE_PIN N3  IOSTANDARD LVCMOS33 } [get_ports {led[13]}]
set_property -dict { PACKAGE_PIN P1  IOSTANDARD LVCMOS33 } [get_ports {led[14]}]
set_property -dict { PACKAGE_PIN L1  IOSTANDARD LVCMOS33 } [get_ports {led[15]}]
