GiorgosNtakos/Hummingbird-2-FPGA-Implementation-for-Lightweight-Authenticated-Encryption-in-IoT/(notices)

Notices in the files:
Thesis_Implementation/README.md:
License: BSD-3-Clause
